erlerobot/openmv/eagle/openmv3_30.10.2014/OpenMV3-manufacturing/README.md

This folder contains the necessary files to manufacture the board.
The work is released under CC-SA 3.0. Please check the design files for more information about the license.

The Gerbers shall be interpreted as follows:
    - *.lyr1 - Layer 1 (Top)
    - *.lyr2 - Layer 2
    - *.lyr3 - Layer 3
    - *.lyr4 - Layer 4
    - *.tslk - Top SilkScreen
    - *.bslk - Bottom SilkScreen
    - *.tstop - Top Stopmask
    - *.bstop - Bottom Stopmask
    - *.mnt   - Mount Top
    - *.mnb   - Mount Bottom

Drill files:
    - *.ncd
