erlerobot/openmv/eagle/openmv3/manufacturing/BOM-OMV3-603.ods

Sheet: BOM
 | BOM
Part | Descritpion | Qty | MF | MFPN | Digikey PartNo | Farnell PartNo | Newark PartNo | Notes/URLs
C40, C41 | CAP CER 12PF 10V 5% 0603 | 2 | TDK Corporation (http://digikey.com/Suppliers/es/TDK.page?lang=en) | C1608C0G1H120J080AA (http://www.digikey.es/product-detail/en/C1608C0G1H120J080AA/445-1270-1-ND/567672) | 445-1270-1-ND (http://www.digikey.es/product-detail/en/C1608C0G1H120J080AA/445-1270-1-ND/567672) | 1844162 (http://es.farnell.com/tdk/c1608c0g1h120j080aa/capacitor-ceramic-12pf-50v-c0g/dp/1844162) | 90R7633 (http://www.newark.com/tdk/c1608c0g1h120j080aa/capacitor-ceramic-12pf-50v-c0g/dp/90R7633) | Original CL10C120JB8NNNC
C5, C6, C7, C8, C9, C10, C13, C14, C16, C17, C18, C20 | CAP CER 0.1UF 10V 10% X7R 0603 | 12 | Kemet (http://digikey.com/Suppliers/es/Kemet.page?lang=en) | C0603C104K8RACTU (http://www.digikey.es/product-detail/en/C0603C104K8RACTU/399-1095-1-ND/411370) | 399-1095-1-ND (http://www.digikey.es/product-detail/en/C0603C104K8RACTU/399-1095-1-ND/411370) | 2112833 (http://es.farnell.com/kemet/c0603c104k8ractu/cap-mlcc-x7r-100nf-10v-0603/dp/2112833) | 62H0320 (http://www.newark.com/kemet/c0603c104k8ractu/capacitor-ceramic-0-1uf-10v-x7r/dp/62H0320) | Original 1276-1946-1-ND WRONG --> 1UF instead of 0.1 UF
C4, C23, C24 | CAP CER 1UF 10V 10% X7R 0603 | 3 | Taiyo Yuden (http://digikey.com/Suppliers/es/Taiyo-Yuden.page?lang=en) | LMK107B7105KA-T (http://www.digikey.es/product-detail/en/LMK107B7105KA-T/587-1242-1-ND/931019) | 587-1242-1-ND (http://www.digikey.es/product-detail/en/LMK107B7105KA-T/587-1242-1-ND/931019) | 2112849 (http://es.farnell.com/taiyo-yuden/lmk107b7105ka-t/cap-mlcc-x7r-1uf-10v-0603/dp/2112849) | 77M8466 (http://www.newark.com/taiyo-yuden/lmk107b7105ka-t/capacitor-ceramic-1uf-10v-x7r/dp/77M8466) | Original device Digikey 587-1454-1-ND
C48, C49 | CAP CER 2.2UF 10V 10% X5R 0603 | 2 | Yageo (http://digikey.com/Suppliers/es/Yageo.page?lang=en) | CC0603KRX5R6BB225 (http://www.digikey.es/product-detail/en/CC0603KRX5R6BB225/311-1451-1-ND/2833757) | 311-1451-1-ND | 1817896 (http://es.farnell.com/yageo/cc0603krx5r6bb225/capacitor-ceramic-2-2uf-10v-x5r/dp/1817896) | 68R4758 (http://www.newark.com/yageo/cc0603krx5r6bb225/capacitor-ceramic-2-2uf-10v-x5r/dp/68R4758)
C15, C19 | CAP CER 4.7UF 10V 10% X5R 0603 | 2 | TDK Corporation (http://digikey.com/Suppliers/es/TDK.page?lang=en) | CGB3B1X5R1A475K055AC (http://www.digikey.es/product-detail/en/CGB3B1X5R1A475K055AC/445-7482-1-ND/2733554) | 445-7482-1-ND (http://www.digikey.es/product-detail/en/CGB3B1X5R1A475K055AC/445-7482-1-ND/2733554) | 2346974 (http://es.farnell.com/tdk/cgb3b1x5r1a475k055ac/cap-mlcc-x5r-4-7uf-10v-0603/dp/2346974) | 51T2634 (http://www.newark.com/tdk/cgb3b1x5r1a475k055ac/cap-ceramic-4-7uf-10v-x5r-0603/dp/51T2634) | Original device Digikey 587-3416-1-ND
C1 | CAP CER 22UF 10V 20% X7R 0805 | 1 | TDK Corporation (http://digikey.com/Suppliers/es/TDK.page?lang=en) | C2012X5R1A226M125AB (http://www.digikey.es/product-detail/en/C2012X5R1A226M125AB/445-7665-1-ND/2733737) | 445-7665-1-ND (http://www.digikey.es/product-detail/en/C2012X5R1A226M125AB/445-7665-1-ND/2733737) | 2354118 | 04X3271 (http://www.newark.com/tdk/c2012x5r1a226m125ab/cap-ceramic-22uf-10v-x5r-0805/dp/04X3271) | uSD cap 22uF-47uF , original 1276-2910-2-ND, X5R choosen instead of X7R
C2, C3 | CAP CER 100UF 10V 20% X5R 1210 | 2 | Kemet (http://digikey.com/Suppliers/es/Kemet.page?lang=en) | C1210C107M8PACTU (http://www.digikey.es/product-detail/en/C1210C107M8PACTU/399-11631-2-ND/4918884) | 399-11631-1-ND (http://www.digikey.es/product-detail/en/C1210C107M8PACTU/399-11631-1-ND/4918887) | 2442786 | 87X8674 | Original CL32A107MPVNNNE
C11 | CAP CER 22UF 10V 20% X5R 1206 | 1 | Kemet (http://digikey.com/Suppliers/es/Kemet.page?lang=en) | C1206C226M8PACTU (http://www.digikey.es/product-detail/en/C1206C226M8PACTU/399-5500-1-ND/1950678) | 399-5500-1-ND (http://www.digikey.es/product-detail/en/C1206C226M8PACTU/399-5500-1-ND/1950678) | 1601818 (http://es.farnell.com/kemet/c1206c226m8pactu/capacitor-ceramic-22uf-10v-x5r/dp/1601818) | 94M5671 (http://www.newark.com/kemet/c1206c226m8pactu/capacitor-ceramic-22uf-10v-x5r/dp/94M5671) | Originally 47UF in BOM
R1 | RES 10 OHM 1/10W 1% 0603 SMD | 1 | Yageo (http://digikey.com/Suppliers/es/Yageo.page?lang=en) | RC0603FR-0710RL (http://www.digikey.es/product-detail/en/RC0603FR-0710RL/311-10.0HRTR-ND/726879) | 311-10.0HRCT-ND | 2128714 (http://es.farnell.com/yageo/rc0603fr-0710rl/resistor-thick-film-10-ohm-100mw/dp/2128714) | 68R0050 (http://www.newark.com/yageo/rc0603fr-0710rl/resistor-thick-film-10-ohm-100mw/dp/68R0050)
R5 | RES 10K OHM 1/10W 5% 0603 SMD | 1 | Yageo (http://digikey.com/Suppliers/es/Yageo.page?lang=en) | RC0603JR-0710KL (http://www.digikey.es/product-detail/en/RC0603JR-0710KL/311-10KGRTR-ND/726700) | 311-10KGRCT-ND | 9233504RL (http://es.farnell.com/yageo-phycomp/rc0603jr-0710kl/resistor-rc21-0603-10k/dp/9233504RL) | 68R0144 (http://www.newark.com/yageo/rc0603jr-0710kl/resistor-thick-film-10kohm-100mw/dp/68R0144)
RN5, RN6 | RES ARRAY 10K OHM 4 RES 1206 | 2 | Yageo (http://digikey.com/Suppliers/es/Yageo.page?lang=en) | YC164-JR-0710KL (http://www.digikey.es/product-detail/en/YC164-JR-0710KL/YC164J-10KCT-ND/1005702) | YC164J-10KCT-ND | 1799564 (http://es.farnell.com/yageo/yc164-jr-0710kl/resistor-iso-array-4res-10kohm/dp/1799564) | 68R0340 (http://www.newark.com/yageo/yc164-jr-0710kl/resistor-iso-array-4res-10kohm/dp/68R0340)
RN7 | RES ARRAY 10K OHM 2 RES 0606 | 1 | CTS Resistor Products (http://digikey.com/Suppliers/es/CTS.page?lang=en) | 742C043103JP (http://www.digikey.es/product-detail/en/742C043103JP/742C043103JPTR-ND/1124426) | 742C043103JPCT-ND (http://www.digikey.es/product-detail/en/742C043103JP/742C043103JPCT-ND/1124587) |  |  | Original 742C043103JPCT-ND, no he encontrado sustituto
RN4 | RES ARRAY 220 OHM 4 RES 1206 | 1 | Yageo (http://digikey.com/Suppliers/es/Yageo.page?lang=en) | TC164-JR-07220RL (http://www.digikey.es/product-detail/en/TC164-JR-07220RL/TC164J-220TR-ND/1004820) | TC164J-220CT-ND | 9241213 (http://es.farnell.com/yageo-phycomp/tc164-jr-07220rl/resistor-array-arc241-1206-220r/dp/9241213) | 98K8153 | 220R-330R
RN8 | RES ARRAY 33 OHM 2 RES 0603 | 1 |  |  | 742C043330JPCT-ND
U7, U6, U3 | FERRITE BEAD 15 OHM SMD 0603 | 3 | TDK Corporation (http://digikey.com/Suppliers/es/TDK.page?lang=en) | MMZ1608R150ATA00 (http://www.digikey.es/product-detail/en/MMZ1608R150ATA00/445-2180-1-ND/765087) | 445-2180-1-ND (http://www.digikey.es/product-detail/en/MMZ1608R150ATA00/445-2180-1-ND/765087) | 2136481 | 89R3087 | Original 445-2184-2-ND
D1, D2 | DIODE SCHOTTKY 20V 1A SOD323 | 2 | Micro Commercial Co (http://digikey.com/Suppliers/es/Micro-Commercial-Components.page?lang=en) | B5817WS-TP (http://www.digikey.es/product-detail/en/B5817WS-TP/B5817WS-TPMSTR-ND/2213553) | B5817WS-TPMSCT-ND | 1924336 | 51T4879 (http://www.newark.com/micro-commercial-components/b5817ws-tp/schottky-rectifiers-1a-20v-sod/dp/51T4879)
U2 | USD W/DETECT | 1 | MOLEX (http://es.farnell.com/molex) | 47309-2651 | WM6700DKR-ND (http://www.digikey.es/product-detail/en/0473092651/WM6700DKR-ND/3045121) | 1568092 | 96M8530 (http://www.newark.com/molex/47309-2651/memory-card-connector-8way/dp/96M8530) | Original WM9731CT-ND, selected I think is compatible
U1 | IC REG LDO 3.3V 500mA 8SOIC | 1 |  |  | BD33IA5WEFJ-E2CT-ND |  |  | Sustituto puede ser este BD33GA3WEFJ-E2, pero da 300mA en vez de 500mA
U8 | IC REG LDO 2.5V 150mA TSOT23-5 | 1 | Texas Instruments (http://digikey.com/Suppliers/es/Texas-Instruments.page?lang=en) | TPS78225DDCR (http://www.digikey.es/product-detail/en/TPS78225DDCR/296-23824-1-ND/1958762) | 296-23824-1-ND (http://www.digikey.es/product-detail/en/TPS78225DDCR/296-23824-1-ND/1958762) | 1684755 | 40P0972 (http://www.newark.com/texas-instruments/tps78225ddct/ldo-reg-150ma-1ua-qc-2-5v-5sot/dp/40P0972) | MIN: 2.5v TYP: 2.8v
U12 | IC ARM 180MHz 1MB FLASH | 1 | STMICROELECTRONICS (http://es.farnell.com/stmicroelectronics) | STM32F427VGT6 | STM32F427VGT6 | 2333368 | 99W9926 | If is not available, the above one.
X2 | CONN USB MICRO B | 1 | FCI | 10118192-0001LF (http://www.digikey.es/product-detail/en/10118192-0001LF/609-4613-2-ND/2785387) | 609-4613-1-ND (http://www.digikey.es/product-detail/en/10118192-0001LF/609-4613-1-ND/2785378) |  |  | Alternativa USB3065-30-00-A
Y1 | CRYSTAL 12MHz 12PF SMD 2.5x2.0 | 1 | AKER (http://www.newark.com/aker) | C7S-12.000-12-3030-X |  | 1538812 (http://es.farnell.com/aker/c7s-12-000-12-3030-x/crystal-smd-ceramic-12-000mhz/dp/1538812) | 94M6771 | Load Cap CL1/CL2 10pF-15PF Max, Original 887-1831-1-ND (Digikey)
LED1 | LED RGB 4-PLCC | 1 | Cree Inc (http://digikey.com/Suppliers/es/Cree.page?lang=en) | CLVBA-FKA-CAEDH8BBB7A363 (http://www.digikey.es/product-detail/en/CLVBA-FKA-CAEDH8BBB7A363/CLVBA-FKA-CAEDH8BBB7A363TR-ND/2650496) | CLVBA-FKA-CAEDH8BBB7A363TR-ND | 2093939 (http://es.farnell.com/cree/clvba-fka-caedh8bbb7a363/led-hb-rgb-smd-130mw/dp/2093939) | 83T3705 (http://www.newark.com/cree/clvba-fka-caedh8bbb7a363/led-hb-rgb-smd-130mw/dp/83T3705)
LED2, LED3 | LED IR 3MM HI EFF 870NM | 2 | VISHAY SEMICONDUCTOR (http://www.newark.com/vishay-semiconductor) | TSHA4400 | 751-1209-ND |  | 58K2526
Q1 | MOSFET N-CH 50V 220MA SOT-23 | 1 | Fairchild Semiconductor (http://digikey.com/Suppliers/es/Fairchild-Semiconductor.page?lang=en) | BSS138 (http://www.digikey.es/product-detail/en/BSS138/BSS138CT-ND/244294) | BSS138CT-ND | 9845330 (http://es.farnell.com/fairchild-semiconductor/bss138/mosfet-n-chan-50v-220ma-sot-23/dp/9845330) | 58K8769 (http://www.newark.com/fairchild-semiconductor/bss138/n-channel-mosfet-50v-220ma-sot/dp/58K8769)
U9 | OV2640 BGA CSP2 | 1 |  |  | Shenzhen
U$1 | LENS + MOUNT M12/20MM 16x16 | 1 |  |  | Shenzhen |  |  | Need 16x16MM base
 | PCBA | 1 |  |  | Small Batch Assembly

Sheet: Power_Supply
Part No | Details | 100 | 250 | 500 | 1000 |  | TOTAL
AP2126K-ADJTRG1 | soft start 3.3V, 300mA | 0,226 | 0,1598 | 0,12792 | 0,09812 | 1 | 0,09812
MCP1824T-3302E/OT | soft start 3.3V | 0,32 |  |  |  |  | 0
LP5900SD-1.8/NOPBCT-ND | 1.8V, 150mA | 0,243 | 0,23852 | 0,234 | 0,225 | 0 | 0
LP3985IM5-2.5/NOPBCT-ND | 2.5V, 150mA | 0,2066 | 0,20272 | 0,1989 | 0,19125 | 0 | 0
LP3986TL-2518/NOPB | 1.8V/2.5V, 150mA |  |  |  | 0,3645 | 1 | 0,3645
 |  |  |  |  |  |  | 0
 |  |  |  |  |  |  | 0
 |  |  |  |  |  |  | 0,46262 | TOTAL
Soft start circuit | http://electronics.stackexchange.com/questions/9307/how-to-limit-inrush-current
1028-1087-1-ND | usb power switch
AP2411FGE-7 | usb power switch | soft start
Current design: | Part No | 10 | 100 | 1000 | 3000
IC REG LDO 3.3/2.5/1.8V | ADP322ACPZ-135-R7CT-ND | 1,5000 | 1,0900 | 0,8500 | 0,6560

Sheet: PCB
Advanced Circuits
 | Space Between | 0,1
 | Border | 0,25
 | 1 | 1,31
2 | 2,6000 | 3,2200
3 | 3,7000 | 4,6300
4 | 4,8000 | 6,0400
5 | 5,9000 | 7,4500
10 | 11,4000 | 14,5000
3x3 Array
Qty | Same Day | 1-day | 2-day | 3-day | 4-day | 1-week | 2-week | 3-week | 4-week
504 | Call Us | $8,06 | $4,54 | $3,67 | $3,14 | $2,96 | $2,61 | $2,26 | $1,91
1008 | Call Us | $5,61 | $3,15 | $2,54 | $2,17 | $2,04 | $1,80 | $1,55 | $1,30
2007 | Call Us | $4,39 | $2,46 | $1,97 | $1,68 | $1,59 | $1,39 | $1,20 | $1,00
3006 | Call Us | $3,98 | $2,22 | $1,78 | $1,52 | $1,43 | $1,26 | $1,08 | $0,90
Tooling | NRE = $300.00 | (Tooling | waived when | re-ordered) |  | * Testing = | 301,39

Sheet: Assembly
 |  |  |  |  |  | Stats | 23 x402s (20xcap + 2xUSB res + 1xbead) 2 x805s 2 xSOD323 1 LED 4 x res nets 1xsiwtch 1x uSD 1x QFN 1x LQFP100 1x USB 1x Resonator
 | Small Batch Assembly
 | http://www.smallbatchassembly.com/
SMDs | 100 | 500 | 1000 | 2000 | 3000
10 | 7,95 | 4,48 | 4,04 |  | 3,75
20 | 10,86 | 5,41 | 4,72 |  | 4,27
40 | 16,66 | 7,26 | 6,08 |  | 5,30
 | Advanced Circuits (Colorado) |  |  |  |  |  | Notes
 | https://www.my4pcb.com |  |  |  |  |  | BGA >= 31 mil, ball <= 900
 | 100 | 500 | 1000 | 2000 | 3000 |  | SMT >= 0402
No PTH |  | 11,53 | 10,93 | 10,63 | 10,53 |  | fine pitch <= 15mil (0.5mm = 15mil)
2 PTH |  | 14,03 | 13,43 | 13,13 | 13,03 |  | 10-day turnaround is cheapest listed
 |  |  |  |  |  |  | Based on 50 placements, 29 line items, 0 fine pitch, 1 bga
 | Screaming Circuits |  |  |  |  |  | Notes:
 | http://www.screamingcircuits.com/ |  |  |  |  |  | Based on 20-day which is cheapest
 | 100 | 500 | 1000 | 2000 | 3000 |  | Based on 50 placements, 29 line items, 0 fine pitch, 1 bga
No PTH |  | 13,17 | 12,38 | call | call
2 PTH |  | 14,59 | 13,76 | call | call
 | Seed Studio |  |  |  |  |  | Notes:
 | http://www.seeedstudio.com/ |  |  |  |  |  | Seeed
 |  |  |  |  |  |  | Appears to limit runs to 300 on the website; PCBA for 2-10 units.
 | Tiny Circuits |  |  |  |  |  | Notes:
 | http://www.tinycircuits.com |  |  |  |  |  | TinyCircuits
 |  |  |  |  |  |  | Normally doesn't do runs for others, but migh with boards >= 1000
 |  |  |  |  |  |  | Sent BOM and Gerber, waiting to hear back
