erlerobot/openmv/eagle/openmv2/manufacturing/OpenMV2 - BOM.xlsx

Part | Value | Device | Package | Description | MF | MPN | OC_FARNELL | OC_NEWARK | OC_DIGIKEY
C1 | 0.1uF | CAP0402-CAP | 0402-CAP | Capacitor | Yageo | CC0402ZRY5V7BB104 | 1362417 (http://es.farnell.com/yageo-phycomp/cc0402zry5v7bb104/cap-mlcc-y5v-100nf-16v-0402-reel/dp/1362417) | 68R4688 (http://www.newark.com/yageo/cc0402zry5v7bb104/capacitor-ceramic-0-1uf-16v-y5v/dp/68R4688) | 311-1047-2-ND (http://www.digikey.es/product-detail/en/CC0402ZRY5V7BB104/311-1047-2-ND/302781)
C2 | 0.1uF | CAP0402-CAP | 0402-CAP | Capacitor | Yageo | CC0402ZRY5V7BB104 | 1362417 (http://es.farnell.com/yageo-phycomp/cc0402zry5v7bb104/cap-mlcc-y5v-100nf-16v-0402-reel/dp/1362417) | 68R4688 (http://www.newark.com/yageo/cc0402zry5v7bb104/capacitor-ceramic-0-1uf-16v-y5v/dp/68R4688) | 311-1047-2-ND (http://www.digikey.es/product-detail/en/CC0402ZRY5V7BB104/311-1047-2-ND/302781)
C3 | 47uF | CAP_POL1206 | EIA3216 | Capacitor Polarized | Kemet | T527I476M010ATE200 | 2390053 (http://es.farnell.com/kemet/t527i476m010ate200/cap-tant-47uf-10v-case-i/dp/2390053) | 39X0244 | 399-10532-1-ND (http://www.digikey.es/product-detail/en/T527I476M010ATE200/399-10532-1-ND/4246291)
C4 | 1uF | CAP0402-CAP | 0402-CAP | Capacitor | TDK Corporation | C1005X5R1E105K050BC | 2346884 (http://es.farnell.com/tdk/c1005x5r1e105k050bc/cap-mlcc-x5r-1uf-25v-0402/dp/2346884) | 05X9838 (http://www.newark.com/tdk/c1005x5r1e105k050bc/cap-mlcc-x5r-1uf-25v-0402/dp/05X9838) | 445-9066-1-ND (http://www.digikey.es/product-detail/en/C1005X5R1E105K050BC/445-9066-1-ND/3648637)
C5 | 0.1uF | CAP0402-CAP | 0402-CAP | Capacitor | Yageo | CC0402ZRY5V7BB104 | 1362417 (http://es.farnell.com/yageo-phycomp/cc0402zry5v7bb104/cap-mlcc-y5v-100nf-16v-0402-reel/dp/1362417) | 68R4688 (http://www.newark.com/yageo/cc0402zry5v7bb104/capacitor-ceramic-0-1uf-16v-y5v/dp/68R4688) | 311-1047-2-ND (http://www.digikey.es/product-detail/en/CC0402ZRY5V7BB104/311-1047-2-ND/302781)
C6 | 0.1uF | CAP0402-CAP | 0402-CAP | Capacitor | Yageo | CC0402ZRY5V7BB104 | 1362417 (http://es.farnell.com/yageo-phycomp/cc0402zry5v7bb104/cap-mlcc-y5v-100nf-16v-0402-reel/dp/1362417) | 68R4688 (http://www.newark.com/yageo/cc0402zry5v7bb104/capacitor-ceramic-0-1uf-16v-y5v/dp/68R4688) | 311-1047-2-ND (http://www.digikey.es/product-detail/en/CC0402ZRY5V7BB104/311-1047-2-ND/302781)
C7 | 0.1uF | CAP0402-CAP | 0402-CAP | Capacitor | Yageo | CC0402ZRY5V7BB105 | 1362417 (http://es.farnell.com/yageo-phycomp/cc0402zry5v7bb104/cap-mlcc-y5v-100nf-16v-0402-reel/dp/1362417) | 68R4688 (http://www.newark.com/yageo/cc0402zry5v7bb104/capacitor-ceramic-0-1uf-16v-y5v/dp/68R4688) | 311-1047-2-ND (http://www.digikey.es/product-detail/en/CC0402ZRY5V7BB104/311-1047-2-ND/302781)
C8 | 0.1uF | CAP0402-CAP | 0402-CAP | Capacitor | Yageo | CC0402ZRY5V7BB106 | 1362417 (http://es.farnell.com/yageo-phycomp/cc0402zry5v7bb104/cap-mlcc-y5v-100nf-16v-0402-reel/dp/1362417) | 68R4688 (http://www.newark.com/yageo/cc0402zry5v7bb104/capacitor-ceramic-0-1uf-16v-y5v/dp/68R4688) | 311-1047-2-ND (http://www.digikey.es/product-detail/en/CC0402ZRY5V7BB104/311-1047-2-ND/302781)
C9 | 0.1uF | CAP0402-CAP | 0402-CAP | Capacitor | Yageo | CC0402ZRY5V7BB107 | 1362417 (http://es.farnell.com/yageo-phycomp/cc0402zry5v7bb104/cap-mlcc-y5v-100nf-16v-0402-reel/dp/1362417) | 68R4689 (http://www.newark.com/yageo/cc0402zry5v7bb104/capacitor-ceramic-0-1uf-16v-y5v/dp/68R4688) | 311-1047-2-ND (http://www.digikey.es/product-detail/en/CC0402ZRY5V7BB104/311-1047-2-ND/302781)
C10 | 0.1uF | CAP0402-CAP | 0402-CAP | Capacitor | Yageo | CC0402ZRY5V7BB108 | 1362417 (http://es.farnell.com/yageo-phycomp/cc0402zry5v7bb104/cap-mlcc-y5v-100nf-16v-0402-reel/dp/1362417) | 68R4690 (http://www.newark.com/yageo/cc0402zry5v7bb104/capacitor-ceramic-0-1uf-16v-y5v/dp/68R4688) | 311-1047-2-ND (http://www.digikey.es/product-detail/en/CC0402ZRY5V7BB104/311-1047-2-ND/302781)
C11 | 100uF | CAP_POL3528 | EIA3528 | Capacitor Polarized | AVX Corporation | F931A107KBA |  |  | 478-8195-2-ND (http://www.digikey.es/product-detail/en/F931A107KBA/478-8195-2-ND/4005266)
C12 | 100uF | CAP_POL1206 | EIA3216 | Capacitor Polarized | Vishay Sprague | TL8A0107M010C | 2425585 (http://es.farnell.com/vishay/tl8a0107m010c/cap-tant-100uf-10v-case-a0/dp/2425585) | 79X2068 | 718-1921-1-ND (http://www.digikey.es/product-detail/en/TL8A0107M010C/718-1921-1-ND/3883166)
C13 | 0.1uF | CAP0402-CAP | 0402-CAP | Capacitor | Yageo | CC0402ZRY5V7BB108 | 1362417 (http://es.farnell.com/yageo-phycomp/cc0402zry5v7bb104/cap-mlcc-y5v-100nf-16v-0402-reel/dp/1362417) | 68R4690 (http://www.newark.com/yageo/cc0402zry5v7bb104/capacitor-ceramic-0-1uf-16v-y5v/dp/68R4688) | 311-1047-2-ND (http://www.digikey.es/product-detail/en/CC0402ZRY5V7BB104/311-1047-2-ND/302781)
C14 | 0.1uF | CAP0402-CAP | 0402-CAP | Capacitor | Yageo | CC0402ZRY5V7BB109 | 1362417 (http://es.farnell.com/yageo-phycomp/cc0402zry5v7bb104/cap-mlcc-y5v-100nf-16v-0402-reel/dp/1362417) | 68R4690 (http://www.newark.com/yageo/cc0402zry5v7bb104/capacitor-ceramic-0-1uf-16v-y5v/dp/68R4688) | 311-1047-2-ND (http://www.digikey.es/product-detail/en/CC0402ZRY5V7BB104/311-1047-2-ND/302781)
C15 | 4.7uF | CAP0402-CAP | 0402-CAP | Capacitor | TDK Corporation | C1005X5R1A475M050BC | 2346881 (http://es.farnell.com/tdk/c1005x5r1a475m050bc/cap-mlcc-x5r-4-7uf-10v-0402/dp/2346881) | 04X3214 (http://www.newark.com/tdk/c1005x5r1a475m050bc/cap-ceramic-4-7uf-10v-x5r-0402/dp/04X3214) | C1005X5R1A475M050BC (http://www.digikey.es/product-detail/en/C1005X5R1A475M050BC/445-8023-1-ND/2792141)
C16 | 0.1uF | CAP0402-CAP | 0402-CAP | Capacitor | Yageo | CC0402ZRY5V7BB109 | 1362417 (http://es.farnell.com/yageo-phycomp/cc0402zry5v7bb104/cap-mlcc-y5v-100nf-16v-0402-reel/dp/1362417) | 68R4690 (http://www.newark.com/yageo/cc0402zry5v7bb104/capacitor-ceramic-0-1uf-16v-y5v/dp/68R4688) | 311-1047-2-ND (http://www.digikey.es/product-detail/en/CC0402ZRY5V7BB104/311-1047-2-ND/302781)
C17 | 0.1uF | CAP0402-CAP | 0402-CAP | Capacitor | Yageo | CC0402ZRY5V7BB110 | 1362417 (http://es.farnell.com/yageo-phycomp/cc0402zry5v7bb104/cap-mlcc-y5v-100nf-16v-0402-reel/dp/1362417) | 68R4690 (http://www.newark.com/yageo/cc0402zry5v7bb104/capacitor-ceramic-0-1uf-16v-y5v/dp/68R4688) | 311-1047-2-ND (http://www.digikey.es/product-detail/en/CC0402ZRY5V7BB104/311-1047-2-ND/302781)
C18 | 0.1uF | CAP0402-CAP | 0402-CAP | Capacitor | Yageo | CC0402ZRY5V7BB110 | 1362417 (http://es.farnell.com/yageo-phycomp/cc0402zry5v7bb104/cap-mlcc-y5v-100nf-16v-0402-reel/dp/1362417) | 68R4690 (http://www.newark.com/yageo/cc0402zry5v7bb104/capacitor-ceramic-0-1uf-16v-y5v/dp/68R4688) | 311-1047-2-ND (http://www.digikey.es/product-detail/en/CC0402ZRY5V7BB104/311-1047-2-ND/302781)
C19 | 4.7uF | CAP0402-CAP | 0402-CAP | Capacitor | TDK Corporation | C1005X5R1A475M050BC | 2346881 (http://es.farnell.com/tdk/c1005x5r1a475m050bc/cap-mlcc-x5r-4-7uf-10v-0402/dp/2346881) | 04X3214 (http://www.newark.com/tdk/c1005x5r1a475m050bc/cap-ceramic-4-7uf-10v-x5r-0402/dp/04X3214) | C1005X5R1A475M050BC (http://www.digikey.es/product-detail/en/C1005X5R1A475M050BC/445-8023-1-ND/2792141)
C20 | 0.1uF | CAP0402-CAP | 0402-CAP | Capacitor | Yageo | CC0402ZRY5V7BB110 | 1362417 (http://es.farnell.com/yageo-phycomp/cc0402zry5v7bb104/cap-mlcc-y5v-100nf-16v-0402-reel/dp/1362417) | 68R4690 (http://www.newark.com/yageo/cc0402zry5v7bb104/capacitor-ceramic-0-1uf-16v-y5v/dp/68R4688) | 311-1047-2-ND (http://www.digikey.es/product-detail/en/CC0402ZRY5V7BB104/311-1047-2-ND/302781)
C21 | 100uF | CAP_POL1206 | EIA3216 | Capacitor Polarized | Vishay Sprague | TL8A0107M010C | 2425585 (http://es.farnell.com/vishay/tl8a0107m010c/cap-tant-100uf-10v-case-a0/dp/2425585) | 79X2068 | 718-1921-1-ND (http://www.digikey.es/product-detail/en/TL8A0107M010C/718-1921-1-ND/3883166)
C23 | 10uF | CAP0402-CAP | 0402-CAP | Capacitor | TDK Corporation | C1005X5R0J106M050BC | 2346872 (http://es.farnell.com/tdk/c1005x5r0j106m050bc/cap-mlcc-x5r-10uf-6-3v-0402/dp/2346872) | 05X9827 | 445-8920-1-ND (http://www.digikey.es/product-detail/en/C1005X5R0J106M050BC/445-8920-1-ND/3507812)
C24 | 10uF | CAP0402-CAP | 0402-CAP | Capacitor | TDK Corporation | C1005X5R0J106M050BC | 2346872 (http://es.farnell.com/tdk/c1005x5r0j106m050bc/cap-mlcc-x5r-10uf-6-3v-0402/dp/2346872) | 05X9827 | 445-8920-1-ND (http://www.digikey.es/product-detail/en/C1005X5R0J106M050BC/445-8920-1-ND/3507812)
C25 | 0.1uF | CAP0402-CAP | 0402-CAP | Capacitor | Yageo | CC0402ZRY5V7BB110 | 1362417 (http://es.farnell.com/yageo-phycomp/cc0402zry5v7bb104/cap-mlcc-y5v-100nf-16v-0402-reel/dp/1362417) | 68R4690 (http://www.newark.com/yageo/cc0402zry5v7bb104/capacitor-ceramic-0-1uf-16v-y5v/dp/68R4688) | 311-1047-2-ND (http://www.digikey.es/product-detail/en/CC0402ZRY5V7BB104/311-1047-2-ND/302781)
C26 | 0.1uF | CAP0402-CAP | 0402-CAP | Capacitor | Yageo | CC0402ZRY5V7BB110 | 1362417 (http://es.farnell.com/yageo-phycomp/cc0402zry5v7bb104/cap-mlcc-y5v-100nf-16v-0402-reel/dp/1362417) | 68R4690 (http://www.newark.com/yageo/cc0402zry5v7bb104/capacitor-ceramic-0-1uf-16v-y5v/dp/68R4688) | 311-1047-2-ND (http://www.digikey.es/product-detail/en/CC0402ZRY5V7BB104/311-1047-2-ND/302781)
C27 | 0.1uF | CAP0402-CAP | 0402-CAP | Capacitor | Yageo | CC0402ZRY5V7BB110 | 1362417 (http://es.farnell.com/yageo-phycomp/cc0402zry5v7bb104/cap-mlcc-y5v-100nf-16v-0402-reel/dp/1362417) | 68R4690 (http://www.newark.com/yageo/cc0402zry5v7bb104/capacitor-ceramic-0-1uf-16v-y5v/dp/68R4688) | 311-1047-2-ND (http://www.digikey.es/product-detail/en/CC0402ZRY5V7BB104/311-1047-2-ND/302781)
C28 | 0.1uF | CAP0402-CAP | 0402-CAP | Capacitor | Yageo | CC0402ZRY5V7BB110 | 1362417 (http://es.farnell.com/yageo-phycomp/cc0402zry5v7bb104/cap-mlcc-y5v-100nf-16v-0402-reel/dp/1362417) | 68R4690 (http://www.newark.com/yageo/cc0402zry5v7bb104/capacitor-ceramic-0-1uf-16v-y5v/dp/68R4688) | 311-1047-2-ND (http://www.digikey.es/product-detail/en/CC0402ZRY5V7BB104/311-1047-2-ND/302781)
C29 | 0.1uF | CAP0402-CAP | 0402-CAP | Capacitor | Yageo | CC0402ZRY5V7BB110 | 1362417 (http://es.farnell.com/yageo-phycomp/cc0402zry5v7bb104/cap-mlcc-y5v-100nf-16v-0402-reel/dp/1362417) | 68R4690 (http://www.newark.com/yageo/cc0402zry5v7bb104/capacitor-ceramic-0-1uf-16v-y5v/dp/68R4688) | 311-1047-2-ND (http://www.digikey.es/product-detail/en/CC0402ZRY5V7BB104/311-1047-2-ND/302781)
C30 | 10uF | CAP0805 | 805 | Capacitor | Murata Electronics North America | GRM219R61E106KA12D | 2426961 (http://es.farnell.com/murata/grm219r61e106ka12d/cap-mlcc-x5r-10uf-25v-0805/dp/2426961) | 68X2791 | 490-7207-1-ND (http://www.digikey.es/product-detail/en/GRM219R61E106KA12D/490-7207-1-ND/3900481)
C31 | 0.1uF | CAP0402-CAP | 0402-CAP | Capacitor | Yageo | CC0402ZRY5V7BB110 | 1362417 (http://es.farnell.com/yageo-phycomp/cc0402zry5v7bb104/cap-mlcc-y5v-100nf-16v-0402-reel/dp/1362417) | 68R4690 (http://www.newark.com/yageo/cc0402zry5v7bb104/capacitor-ceramic-0-1uf-16v-y5v/dp/68R4688) | 311-1047-2-ND (http://www.digikey.es/product-detail/en/CC0402ZRY5V7BB104/311-1047-2-ND/302781)
C32 | 0.1uF | CAP0402-CAP | 0402-CAP | Capacitor | Yageo | CC0402ZRY5V7BB110 | 1362417 (http://es.farnell.com/yageo-phycomp/cc0402zry5v7bb104/cap-mlcc-y5v-100nf-16v-0402-reel/dp/1362417) | 68R4690 (http://www.newark.com/yageo/cc0402zry5v7bb104/capacitor-ceramic-0-1uf-16v-y5v/dp/68R4688) | 311-1047-2-ND (http://www.digikey.es/product-detail/en/CC0402ZRY5V7BB104/311-1047-2-ND/302781)
C33 | 2.2uF | CAP0402-CAP | 0402-CAP | Capacitor | TDK Corporation | C1005X5R1A225K050BC | 2346879 (http://es.farnell.com/tdk/c1005x5r1a225k050bc/cap-mlcc-x5r-2-2uf-10v-0402/dp/2346879) | 04X3212 (http://www.newark.com/tdk/c1005x5r1a225k050bc/cap-ceramic-2-2uf-10v-x5r-0402/dp/04X3212) | 445-7392-1-ND (http://www.digikey.es/product-detail/en/C1005X5R1A225K050BC/445-7392-1-ND/2733464)
C34 | 2.2uF | CAP0402-CAP | 0402-CAP | Capacitor | TDK Corporation | C1005X5R1A225K050BC | 2346879 (http://es.farnell.com/tdk/c1005x5r1a225k050bc/cap-mlcc-x5r-2-2uf-10v-0402/dp/2346879) | 04X3212 (http://www.newark.com/tdk/c1005x5r1a225k050bc/cap-ceramic-2-2uf-10v-x5r-0402/dp/04X3212) | 445-7392-1-ND (http://www.digikey.es/product-detail/en/C1005X5R1A225K050BC/445-7392-1-ND/2733464)
C35 | 0.1uF | CAP0402-CAP | 0402-CAP | Capacitor | Yageo | CC0402ZRY5V7BB110 | 1362417 (http://es.farnell.com/yageo-phycomp/cc0402zry5v7bb104/cap-mlcc-y5v-100nf-16v-0402-reel/dp/1362417) | 68R4690 (http://www.newark.com/yageo/cc0402zry5v7bb104/capacitor-ceramic-0-1uf-16v-y5v/dp/68R4688) | 311-1047-2-ND (http://www.digikey.es/product-detail/en/CC0402ZRY5V7BB104/311-1047-2-ND/302781)
C36 | 0.1uF | CAP0402-CAP | 0402-CAP | Capacitor | Yageo | CC0402ZRY5V7BB110 | 1362417 (http://es.farnell.com/yageo-phycomp/cc0402zry5v7bb104/cap-mlcc-y5v-100nf-16v-0402-reel/dp/1362417) | 68R4690 (http://www.newark.com/yageo/cc0402zry5v7bb104/capacitor-ceramic-0-1uf-16v-y5v/dp/68R4688) | 311-1047-2-ND (http://www.digikey.es/product-detail/en/CC0402ZRY5V7BB104/311-1047-2-ND/302781)
C37 | 0.1uF | CAP0402-CAP | 0402-CAP | Capacitor | Yageo | CC0402ZRY5V7BB110 | 1362417 (http://es.farnell.com/yageo-phycomp/cc0402zry5v7bb104/cap-mlcc-y5v-100nf-16v-0402-reel/dp/1362417) | 68R4690 (http://www.newark.com/yageo/cc0402zry5v7bb104/capacitor-ceramic-0-1uf-16v-y5v/dp/68R4688) | 311-1047-2-ND (http://www.digikey.es/product-detail/en/CC0402ZRY5V7BB104/311-1047-2-ND/302781)
C38 | 100uF | CAP_POL3528 | EIA3528 | Capacitor Polarized | AVX Corporation | TPSB107M010R0400 | 1658510 (http://es.farnell.com/avx/tpsb107m010r0400/cap-tant-100uf-10v-case-b/dp/1658510) | 10R5878 (http://www.newark.com/avx/tpsb107m010r0400/capacitor-tant-100uf-10v-0-4-ohm/dp/10R5878) | 478-5231-2-ND (http://www.digikey.es/product-detail/en/TPSB107M010R0400/478-5231-2-ND/1472679)
C40 | 18pF | CAP0402-CAP | 0402-CAP | Capacitor | Johanson Technology Inc | 500R07S180GV4T | 1650783 (http://es.farnell.com/johanson-technology/500r07s180gv4t/capacitor-ceramic-multilayer/dp/1650783) | 41M1570 (http://www.newark.com/johanson-technology/500r07s180gv4t/capacitor-rf-ceramic-18pf-50v/dp/41M1570) | 712-1264-1-ND (http://www.digikey.es/product-detail/en/500R07S180GV4T/712-1264-1-ND/1786726)
C41 | 18pF | CAP0402-CAP | 0402-CAP | Capacitor | Johanson Technology Inc | 500R07S180GV4T | 1650783 (http://es.farnell.com/johanson-technology/500r07s180gv4t/capacitor-ceramic-multilayer/dp/1650783) | 41M1570 (http://www.newark.com/johanson-technology/500r07s180gv4t/capacitor-rf-ceramic-18pf-50v/dp/41M1570) | 712-1264-1-ND (http://www.digikey.es/product-detail/en/500R07S180GV4T/712-1264-1-ND/1786726)
C43 | 0.1uF | CAP0402-CAP | 0402-CAP | Capacitor | Yageo | CC0402ZRY5V7BB110 | 1362417 (http://es.farnell.com/yageo-phycomp/cc0402zry5v7bb104/cap-mlcc-y5v-100nf-16v-0402-reel/dp/1362417) | 68R4690 (http://www.newark.com/yageo/cc0402zry5v7bb104/capacitor-ceramic-0-1uf-16v-y5v/dp/68R4688) | 311-1047-2-ND (http://www.digikey.es/product-detail/en/CC0402ZRY5V7BB104/311-1047-2-ND/302781)
H1 | MOUNT-PAD-ROUND2.8 | MOUNT-PAD-ROUND2.8 | 2,8-PAD | MOUNTING PAD, round
H2 | MOUNT-PAD-ROUND2.8 | MOUNT-PAD-ROUND2.8 | 2,8-PAD | MOUNTING PAD, round
H6 | MOUNT-PAD-ROUND2.8 | MOUNT-PAD-ROUND2.8 | 2,8-PAD | MOUNTING PAD, round
H8 | MOUNT-PAD-ROUND2.8 | MOUNT-PAD-ROUND2.8 | 2,8-PAD | MOUNTING PAD, round
J3 | CON_HEADER_1X03 | CON_HEADER_1X03 | M1X3_SMD
J4 | CON_HEADER_1X03 | CON_HEADER_1X03 | M1X3_SMD
JP1 |  | PINHD-1X10 | 1X10 | PIN HEADER
JP2 |  | PINHD-1X10 | 1X10 | PIN HEADER
LED1 | LED-TRICOLOR | LED-TRICOLOR | LED-TRICOLOR-SMD | Tri-Color LED SMD
LED2 |  | LED3MM | LED3MM | LEDs
LED3 |  | LED3MM | LED3MM | LEDs
LOGO1 | OSHW_LOGO_FILLX0200-NT | OSHW_LOGO_FILLX0200-NT | OSHW_FILLX200_NOTEXT
Q1 | MOSFET | MOSFET-NCHANNELSMD | SOT23-3
R1 | 10K | RESISTOR0402-RES | 0402-RES | Resistor
R4 | 10ohm | RESISTOR0402-RES | 0402-RES | Resistor
R5 | 10k | RESISTOR0402-RES | 0402-RES | Resistor
R12 | 1K | RESISTOR0402-RES | 0402-RES | Resistor
RN2 |  | 4R-NCAT16 | CAT16 | Array Chip Resistor |  |  | unknown | unknown
RN4 |  | 4R-NCAT16 | CAT16 | Array Chip Resistor |  |  | unknown | unknown
RN5 |  | 4R-NCAT16 | CAT16 | Array Chip Resistor |  |  | unknown | unknown
RN6 |  | 4R-NCAT16 | CAT16 | Array Chip Resistor |  |  | unknown | unknown
RN7 |  | 2R-NEXBV4V | EXBV4V | Array Chip Resistor |  |  | unknown | unknown
RN8 |  | 4R-NCAT16 | CAT16 | Array Chip Resistor |  |  | unknown | unknown
U$1 | LENSMOUNT | LENSMOUNT | LENSMOUNT
U$14 | FIDUCIAL | FIDUCIAL | FIDUCIAL_1MM | For use by pick and place machines to calibrate the vision/machine, 1mm
U$15 | FIDUCIAL | FIDUCIAL | FIDUCIAL_1MM | For use by pick and place machines to calibrate the vision/machine, 1mm
U$16 | FIDUCIAL | FIDUCIAL | FIDUCIAL_1MM | For use by pick and place machines to calibrate the vision/machine, 1mm
U$17 | FIDUCIAL | FIDUCIAL | FIDUCIAL_1MM | For use by pick and place machines to calibrate the vision/machine, 1mm
U$19 | FIDUCIAL | FIDUCIAL | FIDUCIAL_1MM | For use by pick and place machines to calibrate the vision/machine, 1mm
U$20 | FIDUCIAL | FIDUCIAL | FIDUCIAL_1MM | For use by pick and place machines to calibrate the vision/machine, 1mm
U1 | TPS2114APW | TPS2115APW | TSSOP8 | C OR CTRLR SRC SELECT 8TSSOP | Texas Instruments | TPS2115APWR | 2368258 (http://es.farnell.com/texas-instruments/tps2115apwr/ic-autoswing-power-mux-5-5v-8/dp/2368258) | 94T5091 (http://www.newark.com/texas-instruments/tps2115apwr/ic-autoswing-power-mux-5-5v-8/dp/94T5091) | 296-16940-1-ND (http://www.digikey.es/product-detail/en/TPS2115APWR/296-16940-1-ND/652794)
U2 | USD-47571 | USD-47571 | USD-47571 | CONN MICRO SD CARD PUSH-PULL R/A | Molex Inc | 47571-0001 |  | 45P6234 | WM9731CT-ND (http://www.digikey.es/product-detail/en/0475710001/WM9731CT-ND/4037907)
U3 | BEAD | BEAD | 0402-CAP
U4 | TPS768 | TPS768 | SOIC8
U5 | BEAD | BEAD | 0402-CAP
U6 | BEAD | BEAD | 0402-CAP
U7 | STM32F429 | STM32F429 | LQFP144
U8 | VREG_25 | V_REG_LDOSMD | SOT23-5 | Voltage Regulator LDO
U9 | OV2640 | OV2640 | CSP2
U10 | IS42S16800E | IS42S16800E | TSOPII-54
X1 | USB-MICROB | USB-MICROB | USB-MICROB | USB Connectors
Y1 |  | CRYSTAL | CRYSTAL3.2X2.5 | Crystals
