erlerobot/openmv/eagle/openmv3_30.10.2014/BOMOriginal.ods

Sheet: BOM
BOM |  |  | EACH |  |  |  | TOTAL
Part | Qty | En | 10 | 100 | 1000 | 3000 | 10 | 100 | 1000 | 3000 | PartNo | Notes/URLs
PCB | 1 | 1 | 8.5000 | 5.0400 | 5.0400 | 5.0400 | 8.5000 | 5.0400 | 5.0400 | 5.0400 | OSHPark
CAP CER 12PF 10V 5% 0603 | 2 | 1 | 0.0280 | 0.0127 | 0.0069 | 0.0053 | 0.0560 | 0.0254 | 0.0138 | 0.0106 | 1276-1254-1-ND
CAP CER 0.1UF 10V 10% X7R 0603 | 12 | 1 | 0.0250 | 0.0116 | 0.0063 | 0.0048 | 0.3000 | 0.1392 | 0.0756 | 0.0580 | 1276-1946-1-ND
CAP CER 1UF 10V 10% X7R 0603 | 3 | 1 | 0.0410 | 0.0187 | 0.0102 | 0.0078 | 0.1230 | 0.0561 | 0.0306 | 0.0235 | 587-1454-1-ND
CAP CER 2.2UF 10V 10% X5R 0603 | 2 | 1 | 0.0860 | 0.0408 | 0.0236 | 0.0185 | 0.1720 | 0.0816 | 0.0472 | 0.0369 | 311-1451-1-ND
CAP CER 4.7UF 10V 10% X5R 0603 | 3 | 1 | 0.1350 | 0.0685 | 0.0408 | 0.0320 | 0.4050 | 0.2055 | 0.1224 | 0.0960 | 587-3416-1-ND
CAP CER 22UF 10V 20% X7R 0805 | 2 | 1 | 0.3360 | 0.1680 | 0.1104 | 0.0816 | 0.6720 | 0.3360 | 0.2208 | 0.1632 | 1276-2910-2-ND | uSD cap 22uF-47uF
CAP CER 47UF 10V 20% X5R 1206 | 1 | 1 | 0.6890 | 0.4030 | 0.2795 | 0.1950 | 0.6890 | 0.4030 | 0.2795 | 0.1950 | CL31A476MPHNNNE
RES 10 OHM 1/10W 1% 0603 SMD | 1 | 1 | 0.0150 | 0.0060 | 0.0027 | 0.0023 | 0.0150 | 0.0060 | 0.0027 | 0.0023 | 311-10.0HRCT-ND
RES 10K OHM 1/10W 5% 0603 SMD | 1 | 1 | 0.0110 | 0.0045 | 0.0020 | 0.0018 | 0.0110 | 0.0045 | 0.0020 | 0.0018 | 311-10KGRCT-ND
RES ARRAY 10K OHM 4 RES 1206 | 2 | 1 | 0.0256 | 0.0133 | 0.0058 | 0.0058 | 0.0512 | 0.0266 | 0.0115 | 0.0115 | YC164J-10KCT-ND
RES ARRAY 10K OHM 2 RES 0606 | 1 | 1 | 0.0770 | 0.0297 | 0.0131 | 0.0092 | 0.0770 | 0.0297 | 0.0131 | 0.0092 | 742C043103JPCT-ND
RES ARRAY 220 OHM 4 RES 1206 | 1 | 1 | 0.0530 | 0.0247 | 0.0106 | 0.0106 | 0.0530 | 0.0247 | 0.0106 | 0.0106 | TC164J-220CT-ND | 220R-330R
RES ARRAY 33 OHM 2 RES 0603 | 1 | 1 | 0.0740 | 0.0283 | 0.0125 | 0.0125 | 0.0740 | 0.0283 | 0.0125 | 0.0125 | 742C043330JPCT-ND
FERRITE BEAD 15 OHM SMD 0603 | 3 | 1 | 0.0730 | 0.0436 | 0.0251 | 0.0192 | 0.2190 | 0.1308 | 0.0752 | 0.0576 | 445-2184-2-ND
DIODE SCHOTTKY 20V 1A SOD323 | 2 | 1 | 0.3520 | 0.2075 | 0.0901 | 0.0760 | 0.7040 | 0.4150 | 0.1801 | 0.1520 | B5817WS-TPMSCT-ND
USD W/DETECT | 1 | 1 | 0.8630 | 0.7442 | 0.5412 | 0.5412 | 0.8630 | 0.7442 | 0.5412 | 0.5412 | WM9731CT-ND
IC REG LDO 3.3V 0.3A | 1 | 0 | 0.4000 | 0.2359 | 0.1024 | 0.1024 | 0.0000 | 0.0000 | 0.0000 | 0.0000 | AP2125K-3.3TRG1DICT-ND
IC REG LDO 3.3V 500mA 8SOIC | 1 | 1 | 0.5690 | 0.4264 | 0.2415 | 0.2139 | 0.5690 | 0.4264 | 0.2415 | 0.2139 | BD33IA5WEFJ-E2CT-ND
IC REG LDO 2.5V 150mA TSOT23-5 | 1 | 1 | 0.7980 | 0.6144 | 0.2763 | 0.2763 | 0.7980 | 0.6144 | 0.2763 | 0.2763 | TPS78225DDCR | MIN: 2.5v TYP: 2.8v
IC ARM 168MHz 512KB FLASH | 1 | 0 | 9.8930 | 8.1345 | 5.9360 | 5.9360 | 0.0000 | 0.0000 | 0.0000 | 0.0000 | 497-12075-ND
IC ARM 180MHz 1MB FLASH | 1 | 1 | 15.1000 | 12.8500 | 10.0400 | 10.0400 | 15.1000 | 12.8500 | 10.0400 | 10.0400 | 511-STM32F427VGT6
CONN USB MICRO B | 1 | 1 | 0.4330 | 0.3032 | 0.2599 | 0.2599 | 0.4330 | 0.3032 | 0.2599 | 0.2599 | 609-4613-1-ND
CRYSTAL 12MHz 12PF SMD 2.5x2.0 | 1 | 1 | 0.8470 | 0.7000 | 0.5075 | 0.5530 | 0.8470 | 0.7000 | 0.5075 | 0.5530 | 887-1831-1-ND | Load Cap CL1/CL2 10pF-15PF Max
LED RGB 4-PLCC | 1 | 1 | 0.5500 | 0.4830 | 0.3570 | 0.3230 | 0.5500 | 0.4830 | 0.3570 | 0.3230 | CLVBA-FKA-CAEDH8BBB7A363TR-ND
LED IR 3MM HI EFF 870NM | 2 | 1 | 0.4370 | 0.3136 | 0.1859 | 0.1859 | 0.8740 | 0.6272 | 0.3718 | 0.3718 | 751-1209-ND
MOSFET N-CH 50V 220MA SOT-23 | 1 | 1 | 0.1960 | 0.1096 | 0.0400 | 0.0350 | 0.1960 | 0.1096 | 0.0400 | 0.0350 | BSS138CT-ND
OV2640 BGA CSP2 | 1 | 1 | 2.1300 | 1.8000 | 1.5000 | 1.5000 | 2.1300 | 1.8000 | 1.5000 | 1.5000 | Shenzhen (http://www.aliexpress.com/item/Free-shipping-new-original-5pcs-lot-ov2640-ic/1757621581.html)
LENS + MOUNT M12/20MM 16x16 | 1 | 1 | 0.3 | 0.3 | 0.3 | 0.3 | 0.3000 | 0.3000 | 0.3000 | 0.3000 | Shenzhen (http://www.aliexpress.com/item/100pcs-CCTV-Camera-board-Lens-Fixed-Mount-for-M12-0-5-20mm-screw-distance-Holder/917656147.html) | Need 16x16MM base
PCBA | 1 | 1 | 8.4000 | 8.4000 | 3.2600 | 2.8200 | 8.4000 | 8.4000 | 3.2600 | 2.8200 | Small Batch Assembly
Placements per board | 49 |  |  |  |  |  | $43.18 | $34.31 | $23.83 | $23.11 | COST
BOM Line items |  | 28

Sheet: Power Supply
Part No | Details | 100 | 250 | 500 | 1000 |  | TOTAL
AP2126K-ADJTRG1 | soft start 3.3V, 300mA | 0.226 | 0.1598 | 0.12792 | 0.09812 | 1 | 0.09812
MCP1824T-3302E/OT | soft start 3.3V | 0.32 |  |  |  |  | 0
LP5900SD-1.8/NOPBCT-ND | 1.8V, 150mA | 0.243 | 0.23852 | 0.234 | 0.225 | 0 | 0
LP3985IM5-2.5/NOPBCT-ND | 2.5V, 150mA | 0.2066 | 0.20272 | 0.1989 | 0.19125 | 0 | 0
LP3986TL-2518/NOPB | 1.8V/2.5V, 150mA |  |  |  | 0.3645 | 1 | 0.3645
 |  |  |  |  |  |  | 0
 |  |  |  |  |  |  | 0
 |  |  |  |  |  |  | 0.46262 | TOTAL
Soft start circuit | http://electronics.stackexchange.com/questions/9307/how-to-limit-inrush-current
1028-1087-1-ND | usb power switch
AP2411FGE-7 | usb power switch | soft start
Current design: | Part No | 10 | 100 | 1000 | 3000
IC REG LDO 3.3/2.5/1.8V | ADP322ACPZ-135-R7CT-ND | 1.5000 | 1.0900 | 0.8500 | 0.6560

Sheet: PCB
Advanced Circuits
 | Space Between | 0.1
 | Border | 0.25
 | 1 | 1.31
2 | 2.6000 | 3.2200
3 | 3.7000 | 4.6300
4 | 4.8000 | 6.0400
5 | 5.9000 | 7.4500
10 | 11.4000 | 14.5000
3x3 Array
Qty | Same Day | 1-day | 2-day | 3-day | 4-day | 1-week | 2-week | 3-week | 4-week
504 | Call Us | $8.06 | $4.54 | $3.67 | $3.14 | $2.96 | $2.61 | $2.26 | $1.91
1008 | Call Us | $5.61 | $3.15 | $2.54 | $2.17 | $2.04 | $1.80 | $1.55 | $1.30
2007 | Call Us | $4.39 | $2.46 | $1.97 | $1.68 | $1.59 | $1.39 | $1.20 | $1.00
3006 | Call Us | $3.98 | $2.22 | $1.78 | $1.52 | $1.43 | $1.26 | $1.08 | $0.90
Tooling | NRE = $300.00 | (Tooling | waived when | re-ordered) |  | * Testing = | 301.39

Sheet: Assembly
 |  |  |  |  |  | Stats | 23 x402s (20xcap + 2xUSB res + 1xbead) 2 x805s 2 xSOD323 1 LED 4 x res nets 1xsiwtch 1x uSD 1x QFN 1x LQFP100 1x USB 1x Resonator
 | Small Batch Assembly
 | http://www.smallbatchassembly.com/
SMDs | 100 | 500 | 1000 | 2000 | 3000
10 | 7.95 | 4.48 | 4.04 |  | 3.75
20 | 10.86 | 5.41 | 4.72 |  | 4.27
40 | 16.66 | 7.26 | 6.08 |  | 5.30
 | Advanced Circuits (Colorado) |  |  |  |  |  | Notes
 | https://www.my4pcb.com |  |  |  |  |  | BGA >= 31 mil, ball <= 900
 | 100 | 500 | 1000 | 2000 | 3000 |  | SMT >= 0402
No PTH |  | 11.53 | 10.93 | 10.63 | 10.53 |  | fine pitch <= 15mil (0.5mm = 15mil)
2 PTH |  | 14.03 | 13.43 | 13.13 | 13.03 |  | 10-day turnaround is cheapest listed
 |  |  |  |  |  |  | Based on 50 placements, 29 line items, 0 fine pitch, 1 bga
 | Screaming Circuits |  |  |  |  |  | Notes:
 | http://www.screamingcircuits.com/ |  |  |  |  |  | Based on 20-day which is cheapest
 | 100 | 500 | 1000 | 2000 | 3000 |  | Based on 50 placements, 29 line items, 0 fine pitch, 1 bga
No PTH |  | 13.17 | 12.38 | call | call
2 PTH |  | 14.59 | 13.76 | call | call
 | Seed Studio |  |  |  |  |  | Notes:
 | http://www.seeedstudio.com/ |  |  |  |  |  | Seeed
 | 100 | 500 | 1000 | 2000 | 3000 |  | Appears to limit runs to 300 on the website; PCBA for 2-10 units.
 | Tiny Circuits |  |  |  |  |  | Notes:
 | http://www.tinycircuits.com |  |  |  |  |  | TinyCircuits
 | 100 | 500 | 1000 | 2000 | 3000 |  | Can't do, due to BGA
 | Sierra Circuits (Proto Express)
 | https://www.protoexpress.com |  |  |  |  |  | Notes:
 | 100 | 500 | 1000 | 2000 | 3000 |  | Based on 50 placements, 29 line items, 0 fine pitch, 1 leadless
2 PTH |  | 12.63 | 11.37 |  |  |  | based on 7-day, cheapest, longest turnaround
