erlerobot/openmv/eagle/openmv3_30.10.2014/OpenMV3-manufacturing/stackup-standart-4layers.png

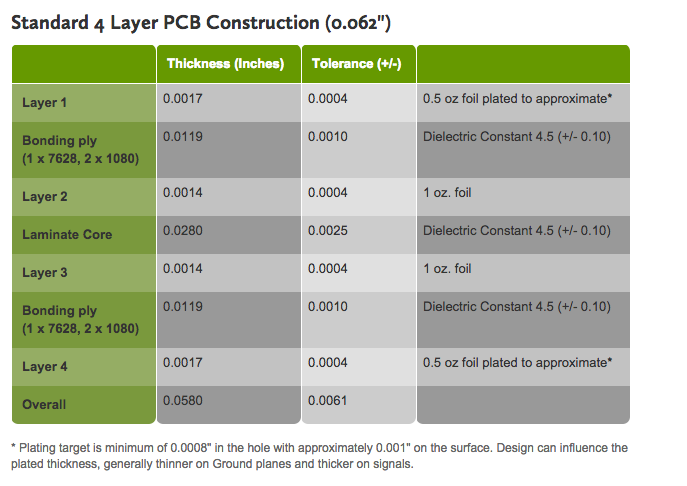
eagle/openmv3_30.10.2014/OpenMV3-manufacturing/stackup-standart-4layers.png
