erlerobot/openmv/(commit log)

2014-10-28 Add manufacturing files
    [OpenMV2 - BOM.xlsx, openmv2.sch]
2014-10-28 BOM fill out: capacitors
    [OpenMV2 - BOM.xlsx]
2014-10-30 Add Openmv3 files
    [OMV3-603.ods, openmv3.brd, openmv3.sch]
2014-10-30 openmv3 BOM first version
    [BOM-OMV3-603.ods]
2014-10-31 Add latest version folder, create the BOM
    [BOM-OMV3-603.ods, BOM-OMV3.ods, BOMOriginal.ods, openmv3.brd, openmv3.sch]
2014-11-04 Add files ready to manufacture, stackup left
    [BOM-OMV3.ods]
2014-11-04 Add pcb stackup file
