erlerobot/openmv/(notices)

Notices in the files:
eagle/openmv3_30.10.2014/openmv3.sch:
Copyright (c) 2013 Ibrahim Abd Elkader
This work is licensed under the Creative Commons Attribution-ShareAlike 3.0 License.
To view a copy of this license, visit http://creativecommons.org/licenses/by-sa/3.0
